Smoria/AM43-WiFi/(threads)

Thread 1 (2021-05-27):

Settings not saved

GraceO77, 2021-05-27:
Firmware uploads ok and AP created. When creating SSID and MQTT settings, they are only saved until the ESP8266 restarts. Eg they are not persistent.
Using an ESP12F
Any thoughts on why?

GraceO77, 2021-05-27:
For anyone else having this issue where the chip goes into AP mode after power cycle. This seemed to be with the delay of 500ms on the wifi before going into AP mode. Change the delay(500) to delay(1000) seems to have solved the issue.

Closed 2021-08-24.

Thread 2 (2021-11-05):

ESPHOME Integration Light sesnor issue

bartbakels, 2021-11-05:
Hi,

It seems the light component is not working  in the ESPHOME implementation. Please contact me if you need more information

regards

Bart

bartbakels, 2021-11-05:
Sorry was a wiring issue

Closed 2021-11-05.

Thread 3 (2022-05-29):

Question: limit set

roblomq, 2022-05-29:
As the original ble control is quite unstable I'm very interested in this modification. I only have a question, as the original app didn't work anymore, how do I set the up and down limits?

Smoria, 2022-05-30:
I just used this instruction to set limits without app.
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

Actually there is already decoded commands in code to do it programmatically, but I have no time to pass it to ESP-Home and test it. So if You have any experience in C++ You could do it by yourself.

The only issue for now is that sometimes control boards just stops responding to UART, so we need to trigger reset pin, which is described in README and after reboot motor just starts moving to upper position without any reason.

Thread 4 (2022-09-24):

webinterface

roblomq, 2022-09-24:
i'm currently experimenting with this AM43-WiFi on a ESP-12F. I think the programming of the ESPhome version worked and it looks like it is connected to my home network but I (ignore my ignorance) but I expected some sort of webinterface. But when i browse to the assigned IP I get a host unreachable error. I use the advanced IP scanner as a tool to find the right IP and this is showing  a device called "livingroom_blinds" so it must be the right IP.

Smoria, 2022-09-25:
It has no web interface in default config, you can use it only as HomeAssistant integration.

If you want to use some sort of web interface, you must implement it by yourself in yaml config.
Follow [ESPHome Web Server Component](https://esphome.io/components/web_server.html) reference to implement web interface

roblomq, 2022-11-05:
That looks a bit too complicated for me. What I want is that i'm able to control the modified AM43 with my Domoticz setup. I have MQTT working there (also HA autodiscovery) but I have no clue in how to create a device in Domoticz that is controlling the AM43.
Can someone help me with this by giving some direction in where to start?

Thread 5 (2023-10-08):

wemos d1 mini or other esp8266 board

loons1k, 2023-10-08:
Thank you for the project. I had a wemos d1 mini at hand, according to your instructions, I “blowed off” (with a rose alloy) the ble chip, soldered the wires and directly connected it to the wemos d1 mini, just swapped the RX and TX positions. Everything works great (esphome), except for the free space inside, I had to remove the battery completely, but the wifi chip is far from ble, in any case it will work on constant power. Thanks again for the project, maybe my path will be a little easier for beginners.
